antmicro/fmc-sata-adapter/fmc2sata.kicad_pcb

## KiCad design fmc2sata.kicad_pcb (2021-02-09)

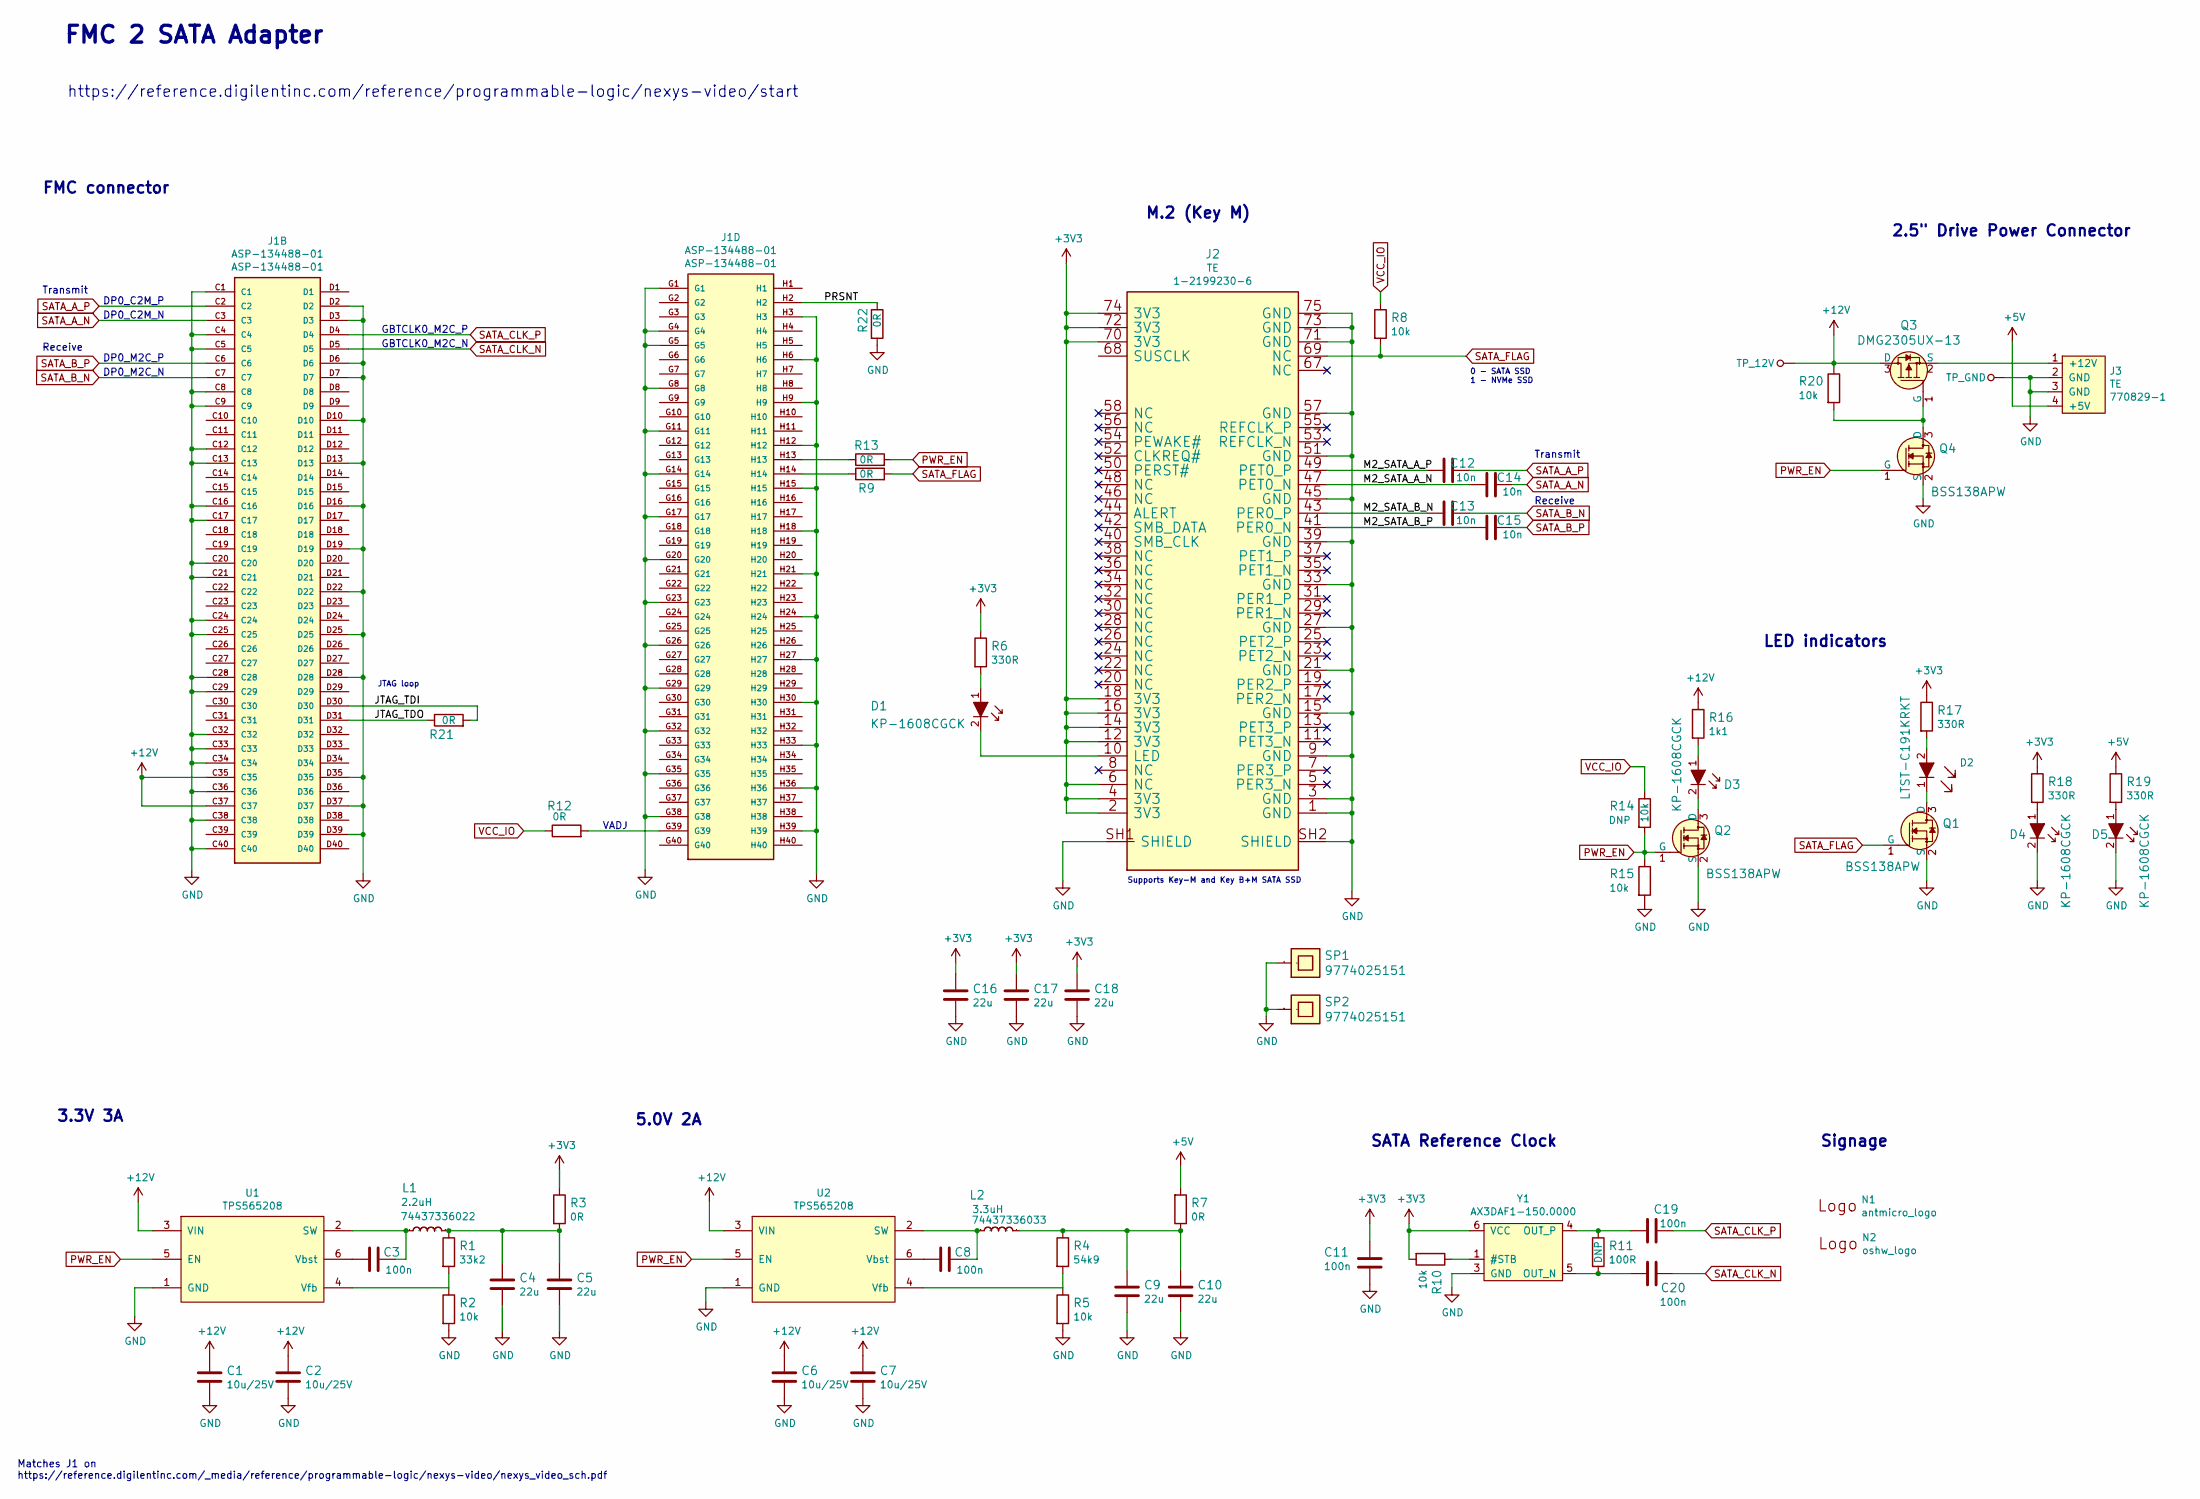
[picture p2: schematic fmc2sata.sch, FMC 2 SATA]

Parts:
C1, C2, C6, C7: C_10u_25V_0603; 0603-cap; MPN C1608X5R1E106M080AC
C3, C8: C_100n_0603; 0603-cap; MPN 0603YC104KAZ2A
C4, C5, C9, C10, C16, C17, C18: C_22u_0805_10V; 0805-cap; MPN 0805ZD226MAT2A
C11, C19, C20: C_100n_0402; 0402-cap; MPN 0402X104K6R3CT
C12, C13, C14, C15: C_10n_0402; 0402-cap; MPN 04025G103ZAT2A
D1, D3, D4, D5: KP-1608CGCK; LED_0603; MPN KP-1608CGCK
D2: LTST-C191KRKT; LED_0603; MPN LTST-C191KRKT
J1: ASP-134488-01; MPN ASP-134488-01
J2: 1-2199230-6; MPN 1-2199230-6
J3: te-770829-1; MPN 770829-1
L1: WE_74437336022; MPN 74437336022
L2: WE_74437336033; MPN 74437336033
N1: antmicro_logo; antmicro-logo_scaled_20mm
N2: oshw_logo; oshw-logo
Q1, Q2, Q4: BSS138APW; SC70-3; MPN BSS138PW
Q3: DMG2305UX-13; SOT-23-3; MPN DMG2305UX-13
R1: R_33k2_0402; 0402-res; MPN ERJ2RKF3322X
R2, R5, R8, R10, R14, R15, R20: R_10k_0402; 0402-res; MPN CRCW040210K0FKEDHP
R3, R7, R9, R12, R13, R21, R22: R_0R_0402; 0402-res; MPN ERJ2GE0R00X
R4: R_54k9_0402; 0402-res; MPN MCMR04X5492FTL
R6, R17, R18, R19: R_330R_0402; 0402-res; MPN MCMR04X3300FTL
R11: R_100R_0402; 0402-res; MPN CR0402-FX-1000GLF
R16: R_1k1_0402; 0402-res; MPN ERJ2RKF1101X
SP1, SP2: 9774025151; MPN 9774025151
TP_12V: TP_SMD1MM; Testpoint_smd_1mm
TP_GND: TP_SMD1MM; Testpoint_smd_1mm
U1, U2: TPS565208; SOT-23-6; MPN TPS565208DDCT
Y1: AX3DAF1-150.0000; AX3DAF1; MPN ASFLMB-12.000MHZ-LC-T

Connections:
+3V3: C11.1, C16.1, C17.1, C18.1, J2.2 (3V3), J2.4 (3V3), J2.6 (NC), J2.12 (3V3), J2.14 (3V3), J2.16 (3V3), J2.18 (3V3), J2.70 (3V3), J2.72 (3V3), J2.74 (3V3), R3.1, R6.1, R10.2, R17.1, R18.1, Y1.6 (VCC)
+5V: J3.4 (+5V), R7.2, R19.1
+12V: C1.1, C2.1, C6.1, C7.1, J1.C35, J1.C37, Q3.3 (D), R16.1, R20.1, TP_12V.1, U1.3 (VIN), U2.3 (VIN); also elsewhere on the board
/JTAG_TDI: J1.D30, R21.2
/JTAG_TDO: J1.D31, R21.1
/M2_SATA_A_N: C14.2, J2.47 (PET0_N)
/M2_SATA_A_P: C12.2, J2.49 (PET0_P)
/M2_SATA_B_N: C13.2, J2.43 (PER0_P)
/M2_SATA_B_P: C15.2, J2.41 (PER0_N)
/PRSNT: J1.H2, R22.1
GND: C1.2, C2.2, C4.2, C5.2, C6.2, C7.2, C9.2, C10.2, C11.2, C16.2, C17.2, C18.2, D4.2, D5.2, J1.C1, J1.C4, J1.C5, J1.C8, J1.C9, J1.C12, J1.C13, J1.C16, J1.C17, J1.C20, J1.C21, J1.C24, J1.C25, J1.C28, J1.C29, J1.C32, J1.C33, J1.C34, J1.C36, J1.C38, J1.C40, J1.D2, J1.D3, J1.D6, J1.D7, J1.D10, J1.D13, J1.D16, J1.D19, J1.D22, J1.D25, J1.D28, J1.D35, J1.D37, J1.D39, J1.G1, J1.G4, J1.G5, J1.G8, J1.G11, J1.G14, J1.G17, J1.G20, J1.G23, J1.G26, J1.G29, J1.G32, J1.G35, J1.G38, J1.H3, J1.H6, J1.H9, J1.H12, J1.H15, J1.H18, J1.H21, J1.H24, J1.H27, J1.H30, J1.H33, J1.H36, J1.H39, J2.1 (GND), J2.3 (GND), J2.9 (GND), J2.15 (GND), J2.21 (GND), J2.27 (GND), J2.33 (GND), J2.39 (GND), J2.45 (GND), J2.51 (GND), J2.57 (GND), J2.71 (GND), J2.73 (GND), J2.75 (GND), J2.SH1 (SHIELD), J2.SH2 (SHIELD), J3.2 (GND), J3.3 (GND), Q1.2 (S), Q2.2 (S), Q4.2 (S), R2.2, R5.2, R15.2, R22.2, SP1.1, SP2.1, TP_GND.1, U1.1 (GND), U2.1 (GND), Y1.3 (GND); also elsewhere on the board
unnamed: C3.1, L1.1, U1.2 (SW)
unnamed: C3.2, U1.6 (Vbst)
unnamed: C4.1, C5.1, L1.2, R1.1, R3.2
unnamed: C8.1, L2.1, U2.2 (SW)
unnamed: C8.2, U2.6 (Vbst)
unnamed: C9.1, C10.1, L2.2, R4.1, R7.1
unnamed: C19.2, R11.1, Y1.4 (OUT_P)
unnamed: C20.2, R11.2, Y1.5 (OUT_N)
unnamed: D1.1, R6.2
unnamed: D1.2, J2.10 (LED)
unnamed: D2.1, Q1.3 (D)
unnamed: D2.2, R17.2
unnamed: D3.1, R16.2
unnamed: D3.2, Q2.3 (D)
unnamed: D4.1, R18.2
unnamed: D5.1, R19.2
unnamed: J1.G39, R12.2
unnamed: J1.H13, R13.1
unnamed: J1.H14, R9.1
unnamed: J3.1 (+12V), Q3.2 (S)
unnamed: Q3.1 (G), Q4.3 (D), R20.2
unnamed: R1.2, R2.1, U1.4 (Vfb)
unnamed: R4.2, R5.1, U2.4 (Vfb)
unnamed: R10.1, Y1.1 (#STB)
PWR_EN: Q2.1 (G), Q4.1 (G), R13.2, R14.2, R15.1, U1.5 (EN), U2.5 (EN)
SATA_A_N: C14.1, J1.C3
SATA_A_P: C12.1, J1.C2
SATA_B_N: C13.1, J1.C7
SATA_B_P: C15.1, J1.C6
SATA_CLK_N: C20.1, J1.D5
SATA_CLK_P: C19.1, J1.D4
SATA_FLAG: J2.69 (NC), Q1.1 (G), R8.2, R9.2
VCC_IO: R8.1, R12.1, R14.1

Notes on the sheet:
FMC 2 SATA Adapter
https://reference.digilentinc.com/reference/programmable-logic/nexys-video/start
0 - SATA SSD 1 - NVMe SSD
Supports Key-M and Key B+M SATA SSD
FMC connector
M.2 (Key M)
Matches J1 on https://reference.digilentinc.com/_media/reference/programmable-logic/nexys-video/nexys_video_sch.pdf
3.3V 3A
SATA Reference Clock
5.0V 2A
GBTCLK0_M2C_P
GBTCLK0_M2C_N
DP0_C2M_P
DP0_C2M_N
DP0_M2C_P
DP0_M2C_N
Transmit
Receive
2.5" Drive Power Connector
Signage
VADJ
LED indicators
JTAG loop

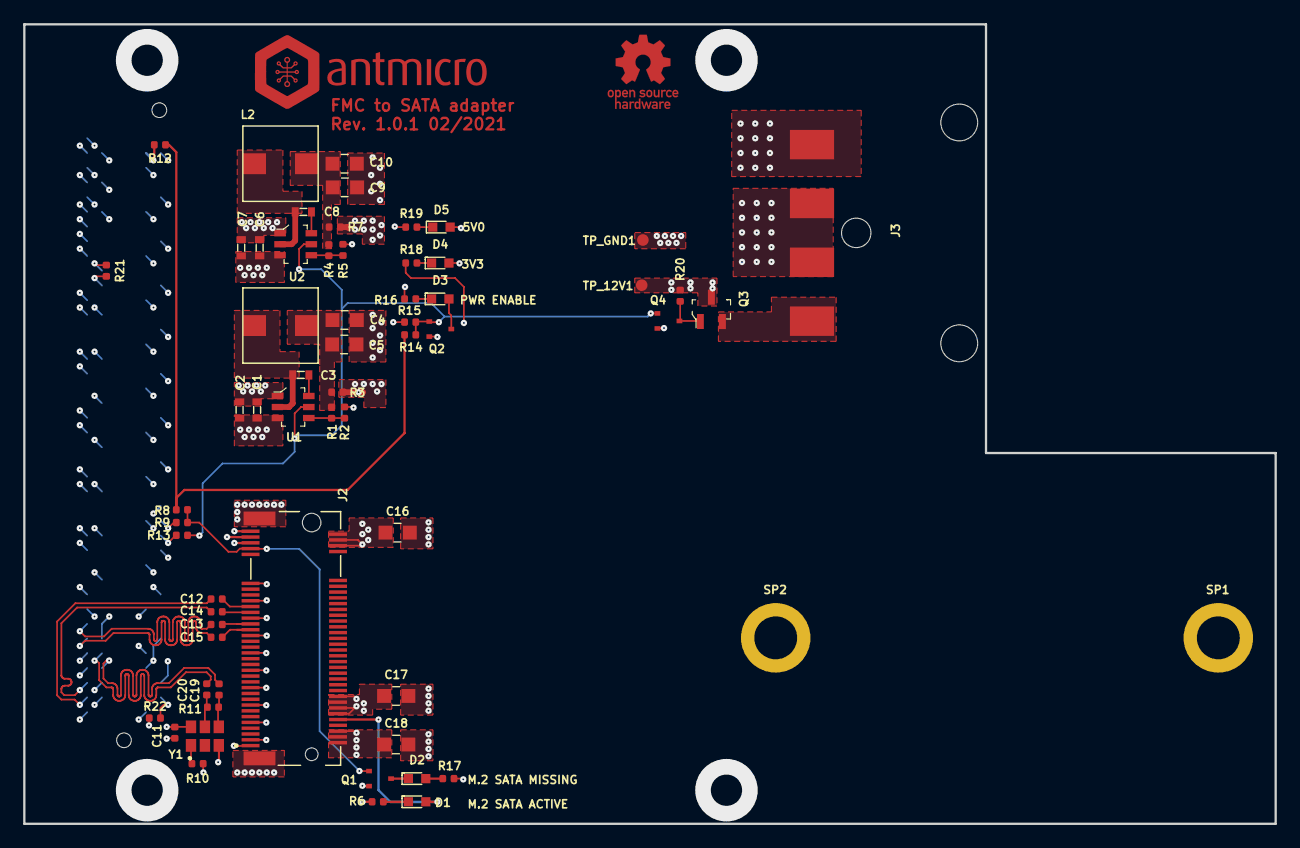
[picture p3: board fmc2sata.kicad_pcb from above]

Board: 4 copper layers, 108.0 x 69.0 mm, 65 parts (1 on the bottom side), 44 nets.

Other parts of the board:
TP_12V1: TP_SMD1MM; Testpoint_smd_1mm
TP_GND1: TP_SMD1MM; Testpoint_smd_1mm

Their connections:
+12V: TP_12V1.1; also elsewhere on the board
GND: TP_GND1.1; also elsewhere on the board
