antmicro/fmc-sata-adapter/(commit log)

2021-01-18 Add initial project file
    [fmc2sata.kicad_pcb, fmc2sata.sch]
2021-01-18 Update folder structure
    [fmc2sata.kicad_pcb, fmc2sata.sch]
2021-01-18 Add FMC male connector
    [fmc2sata.sch]
2021-01-25 Add M.2 with basic connections
    [fmc2sata.sch]
2021-01-25 Add DC/DC converters
    [fmc2sata.sch, power-supply.sch]
2021-01-25 Connect SATA lanes
    [fmc2sata.sch]
2021-01-25 Add basic PCB outline
    [fmc2sata.sch]
2021-01-25 Add 2.5" SATA connector and 150MHz LVDS REF CLK generator
    [fmc2sata.sch]
2021-01-25 Add initial component placement
    [fmc2sata.kicad_pcb]
2021-01-25 Include FMC fastening holes
    [fmc2sata.kicad_pcb]
2021-01-25 Add AMP power connector
2021-01-25 Add board fastening holes
    [fmc2sata.kicad_pcb, fmc2sata.sch]
2021-01-25 Add second M.2 mouting stud
    [fmc2sata.kicad_pcb, fmc2sata.sch]
2021-01-25 Add PWR indicators
    [fmc2sata.kicad_pcb, fmc2sata.sch]
2021-01-25 Update compoent placement
    [fmc2sata.kicad_pcb, fmc2sata.sch]
2021-01-25 Add board name
2021-01-25 Layout in progress
    [fmc2sata.kicad_pcb]
2021-01-25 Add power planes
    [fmc2sata.kicad_pcb]
2021-01-25 Routing in progress
    [fmc2sata.kicad_pcb]
2021-01-25 Component cleanup
    [fmc2sata.kicad_pcb, fmc2sata.sch, power-supply.sch]
2021-01-25 Update local libraries
    [fmc2sata.kicad_pcb, fmc2sata.sch]
2021-01-25 All signals connected, DRC clean
    [fmc2sata.kicad_pcb]
2021-01-25 Add length tunning
    [fmc2sata.kicad_pcb]
2021-01-25 Add filtering caps
    [fmc2sata.kicad_pcb, fmc2sata.sch]
2021-01-25 Update designators, DRC clean
    [fmc2sata.kicad_pcb]
2021-02-09 Bump release to 1.0.1
    [fmc2sata.sch]
2021-02-09 Remove C39 connection
    [fmc2sata.sch]
2021-02-09 Add capacitive coupling to Y1
    [fmc2sata.sch]
2021-02-09 Update layout, DRC clean
    [fmc2sata.kicad_pcb]
2021-02-09 Add testpads for power supply - DRC clean
    [fmc2sata.kicad_pcb, fmc2sata.sch]
2021-02-09 Bump release month on PCB
    [fmc2sata.kicad_pcb]
2021-02-09 Minor fixes in sch
    [fmc2sata.sch]
